bao-eng/glass2glass/(commit log)

2023-09-16 FETs fixed + added inverter
    [cam_delay_meas_photo.kicad_sch]
2023-09-23 tpl1401 driver added
2023-09-23 remove hw files(moved to the separate repo)
    [cam_delay_meas_photo.kicad_pcb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]
2023-09-23 tpl1401_reg_read regaddr argument fixed
    [main.c, tpl1401.h]
2023-09-23 repeating timer added
2023-09-28 use argument i2c instance of default
2023-09-30 Status LED added
2023-09-30 gpio interrupt added
